tass10/tecracing_telemetry/Imagens/FFT_Pressao_da_Linha_de_Freio.png

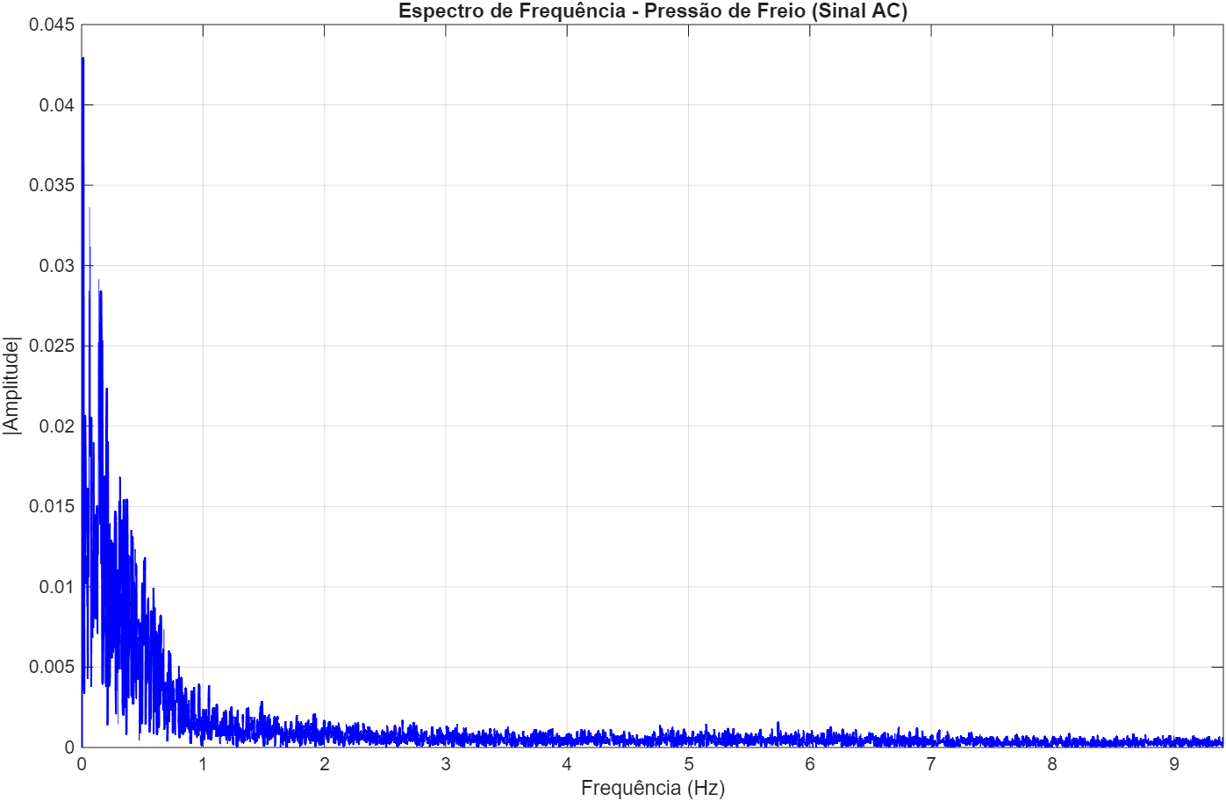
Imagens/FFT_Pressao_da_Linha_de_Freio.png
