tass10/tecracing_telemetry/Imagens/FFT_Temperatura_da_agua_do_motor.png

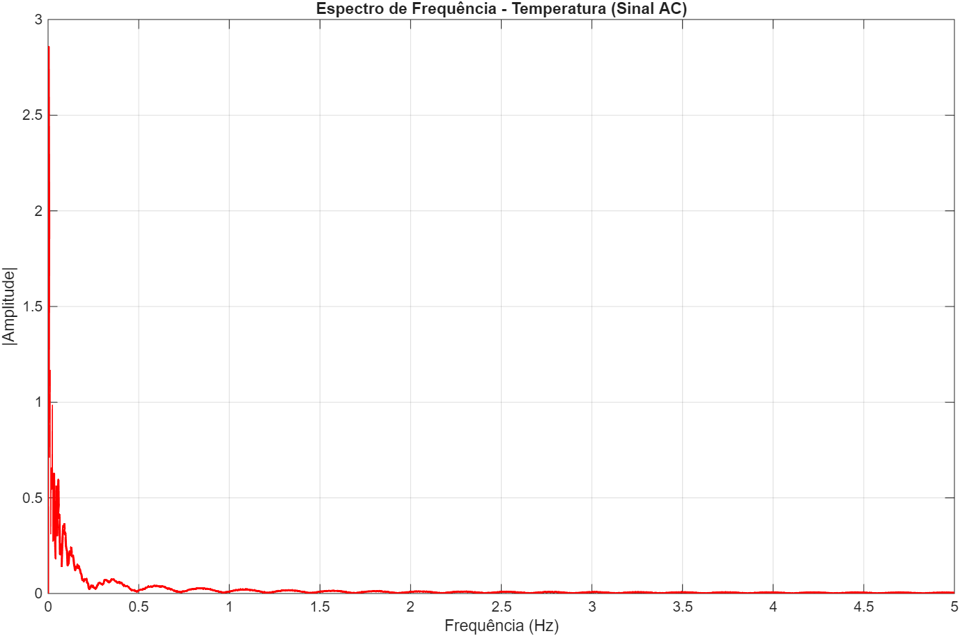
Imagens/FFT_Temperatura_da_agua_do_motor.png
