tass10/tecracing_telemetry/Imagens/Pressao_de_Freio_Comparação_de_Filtros_10_Hz.png

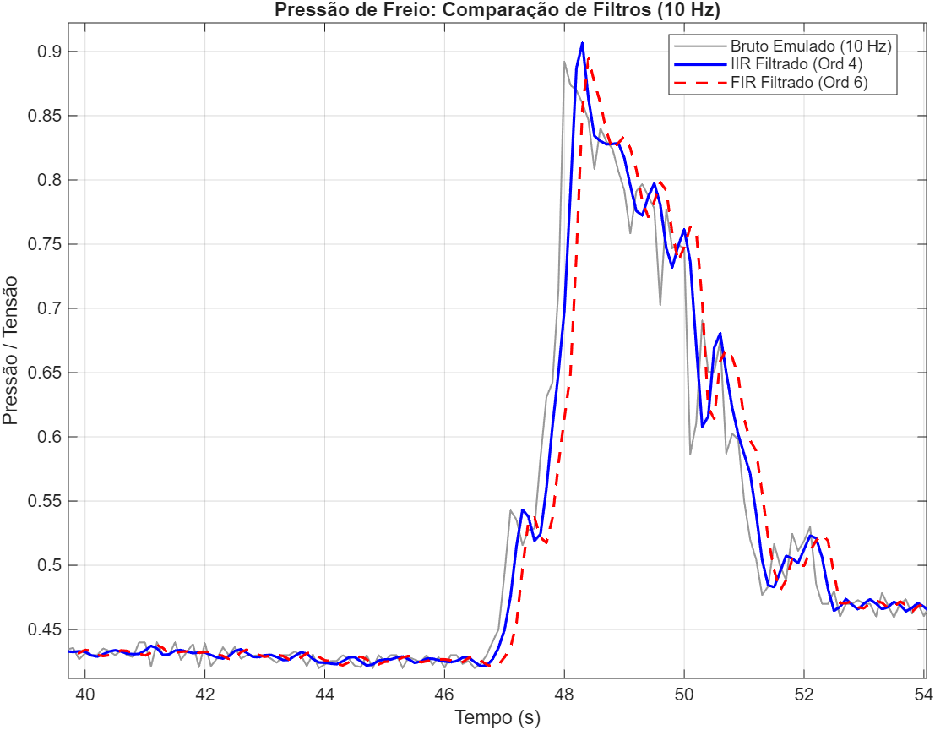
Imagens/Pressao_de_Freio_Comparação_de_Filtros_10_Hz.png
