tass10/tecracing_telemetry/Imagens/Temperatura_da_Agua_Comparação_de_Filtros_10_Hz.png

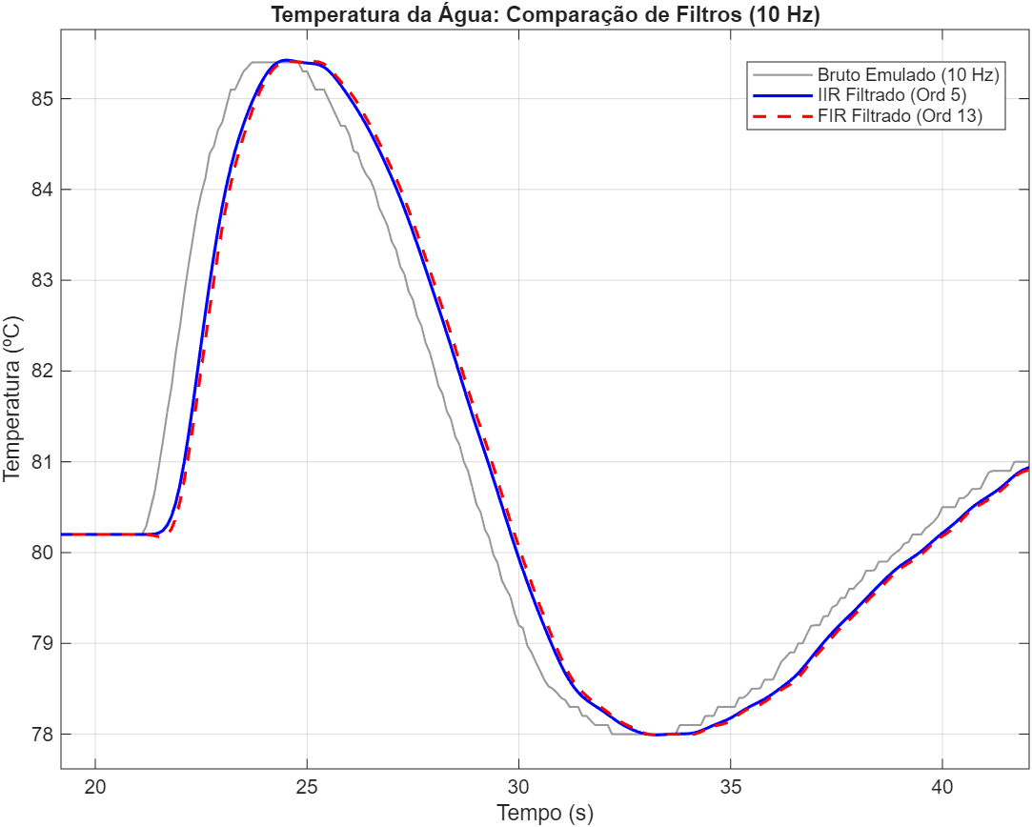
Imagens/Temperatura_da_Agua_Comparação_de_Filtros_10_Hz.png
