tass10/tecracing_telemetry/Imagens/Sistema_Transmissor_Teste.jpg

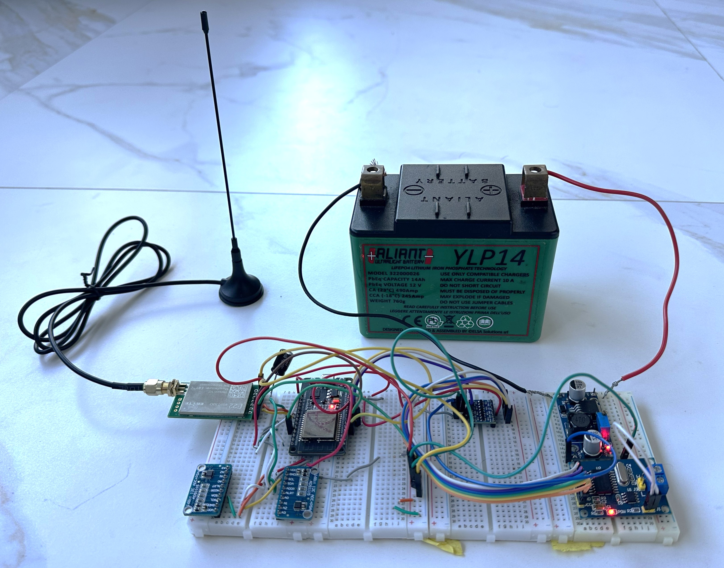
Imagens/Sistema_Transmissor_Teste.jpg
