tass10/tecracing_telemetry/Schematics/20260430_Telemetry_Schematic_Receiver_Tassio.PDF

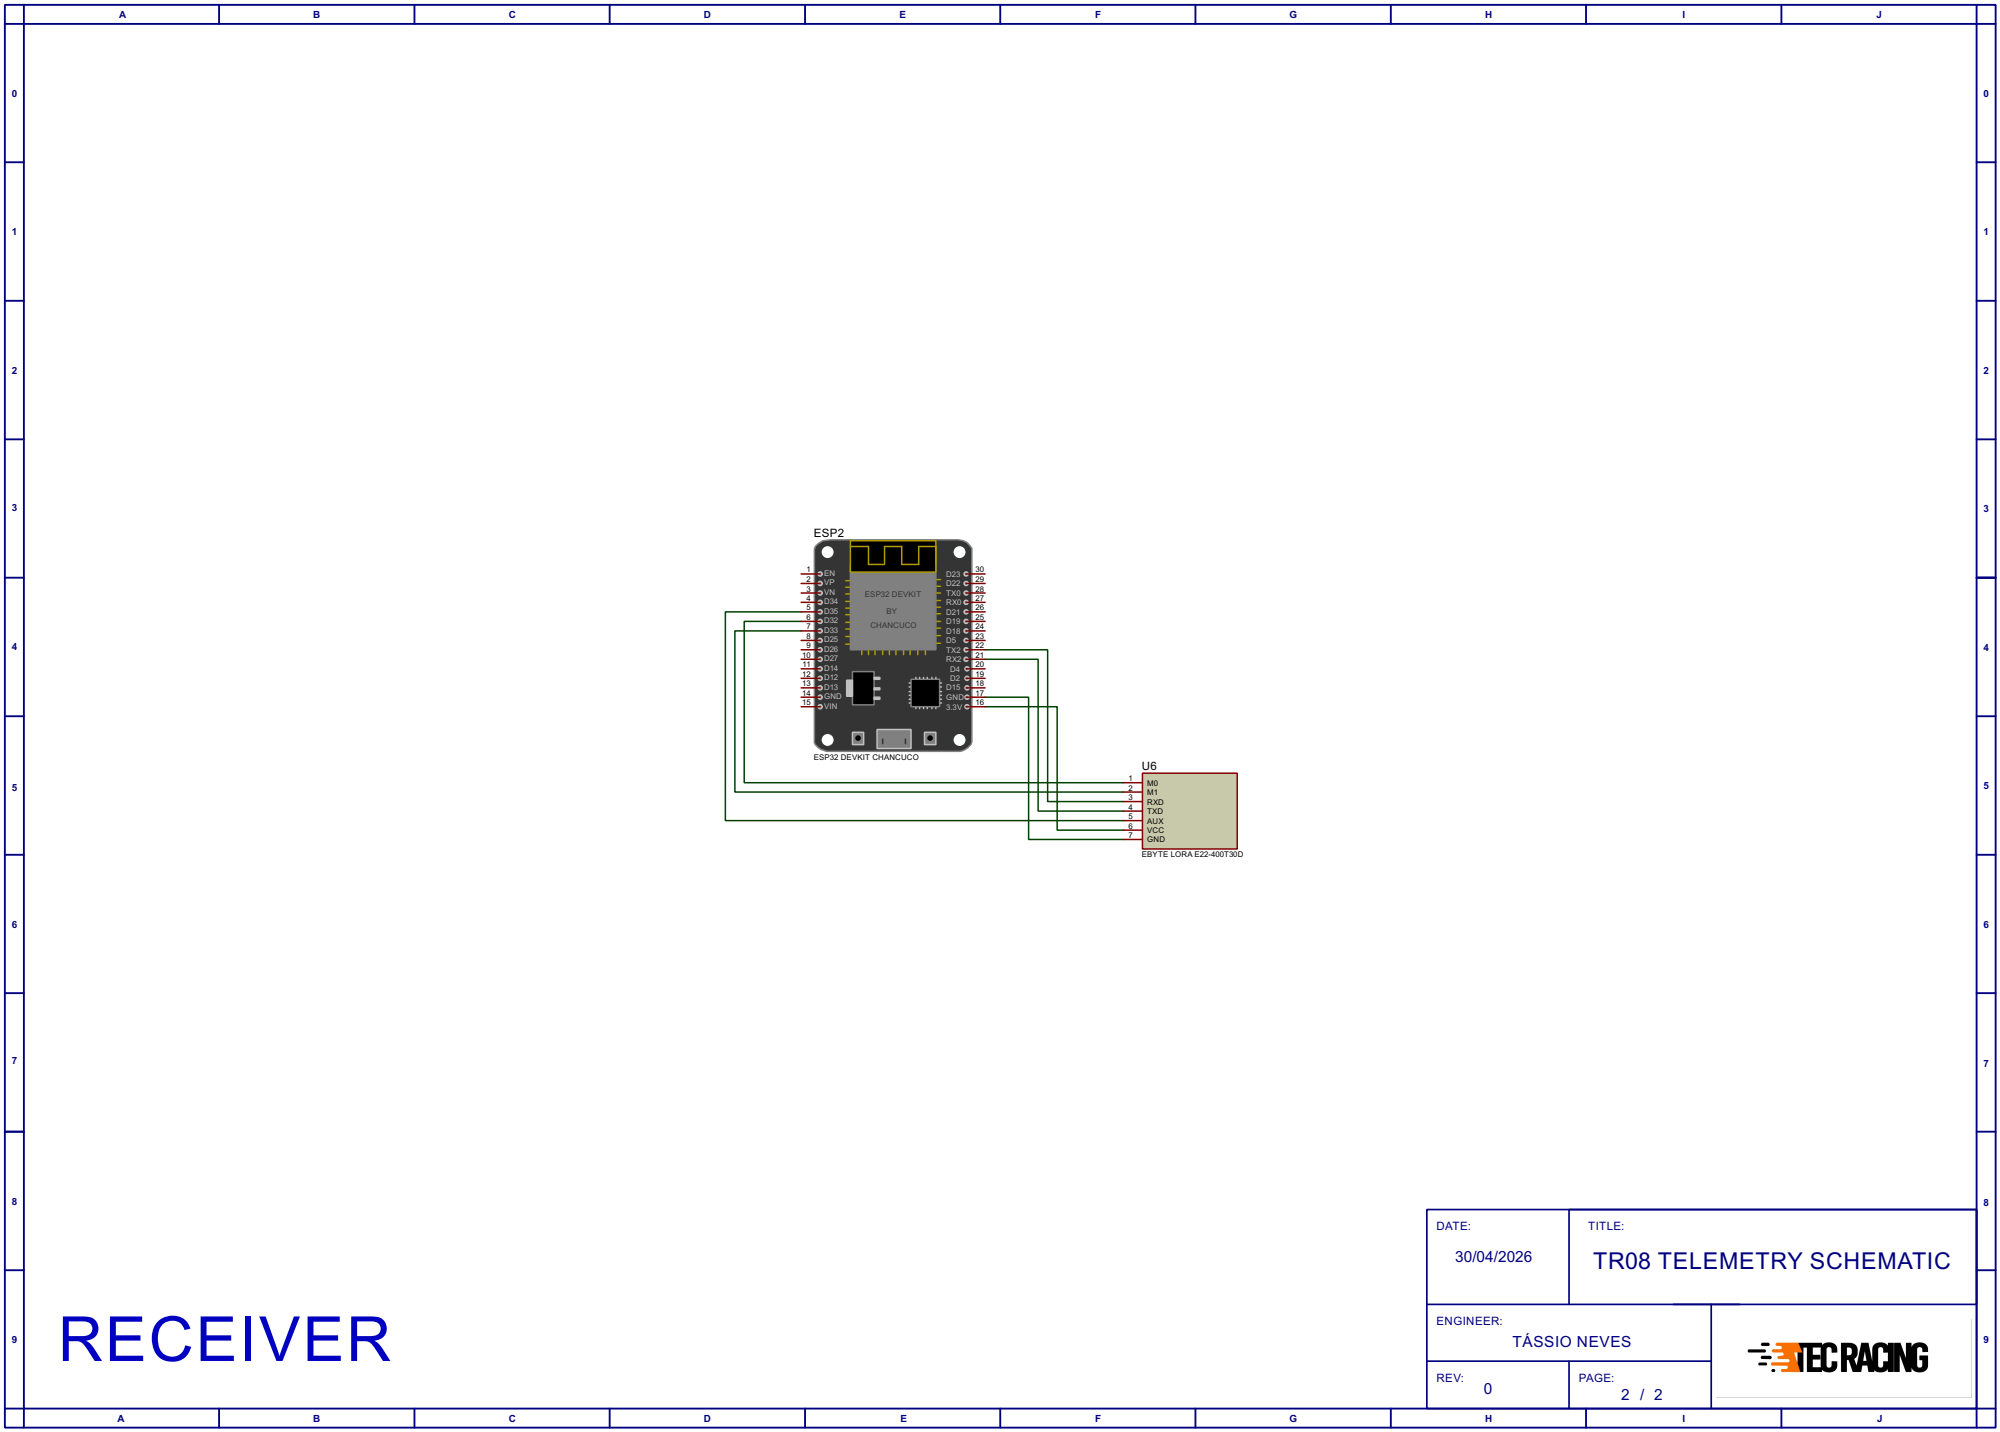
[picture p15: page 1]

6 | 25
7 | 24

DATE: 30/04/2026 | TITLE: TR08 TELEMETRY SCHEMATIC

ENGINEER: TÁSSIO NEVES
