tass10/tecracing_telemetry/Schematics/20260430_Telemetry_Schematic_Transmitter_Tassio.PDF

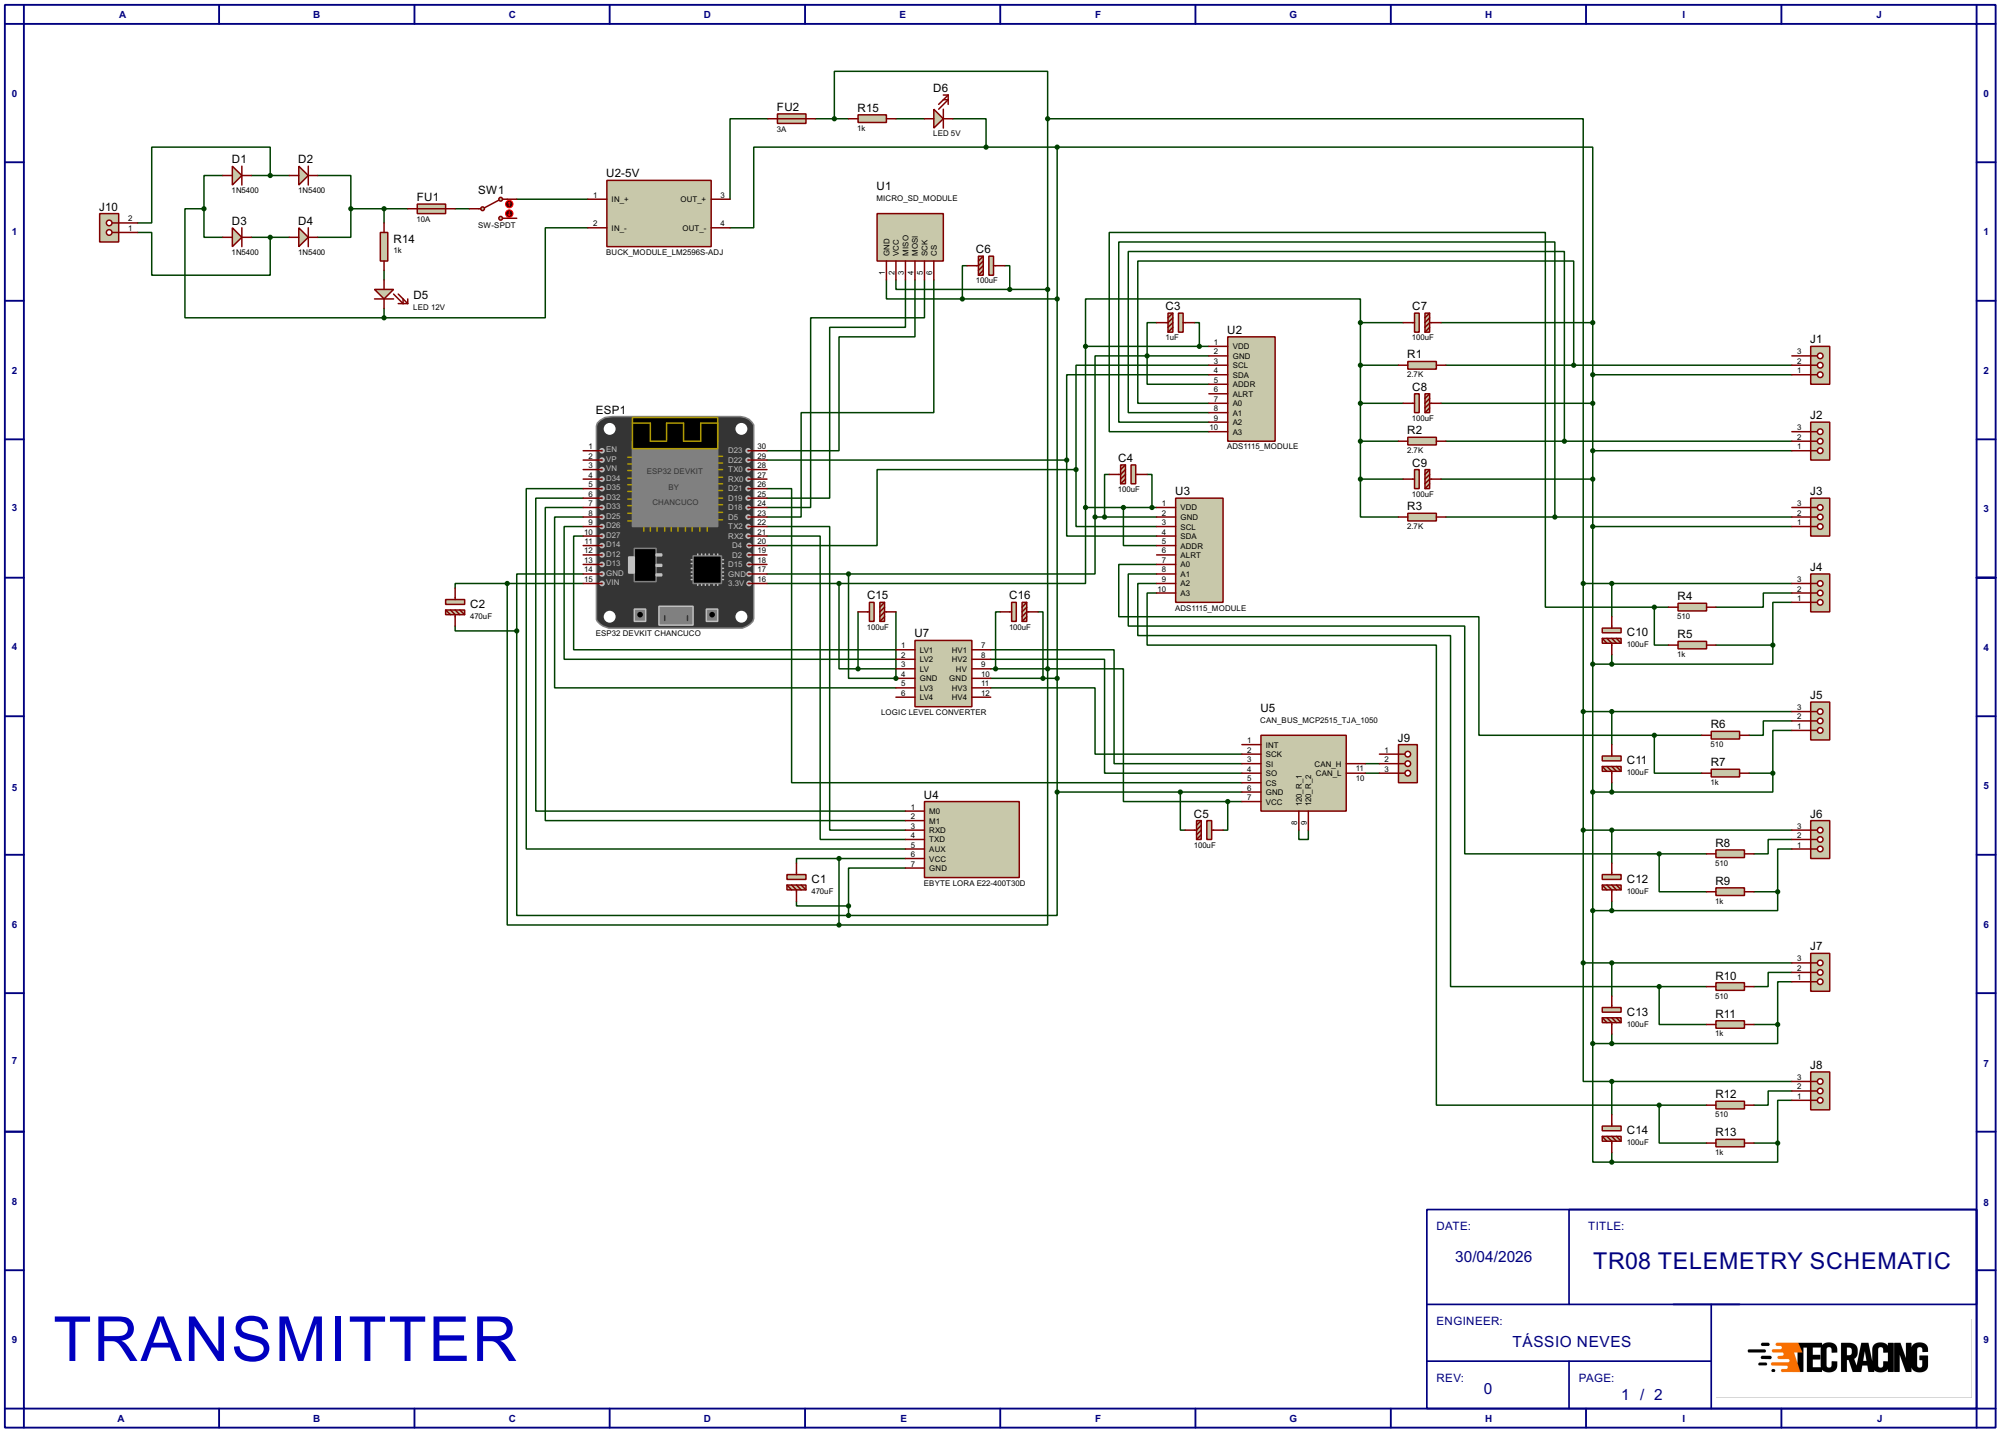
[picture p16: page 1]

SCL SDA ADDR ALRT A0
4 5

ESP32 DEVKIT CHANCUCO

4 | LV3 LV4 | 10 HV3
6 | | 11 HV4 12

U5 CAN_BUS_MCP2515_TJA_1050

DATE: 30/04/2026 | TITLE: TR08 TELEMETRY SCHEMATIC

ENGINEER: TÁSSIO NEVES
