tass10/tecracing_telemetry/Schematics/20260429_Telemetry_Simplified_Schematic_Transmitter_Leonardo.pdf

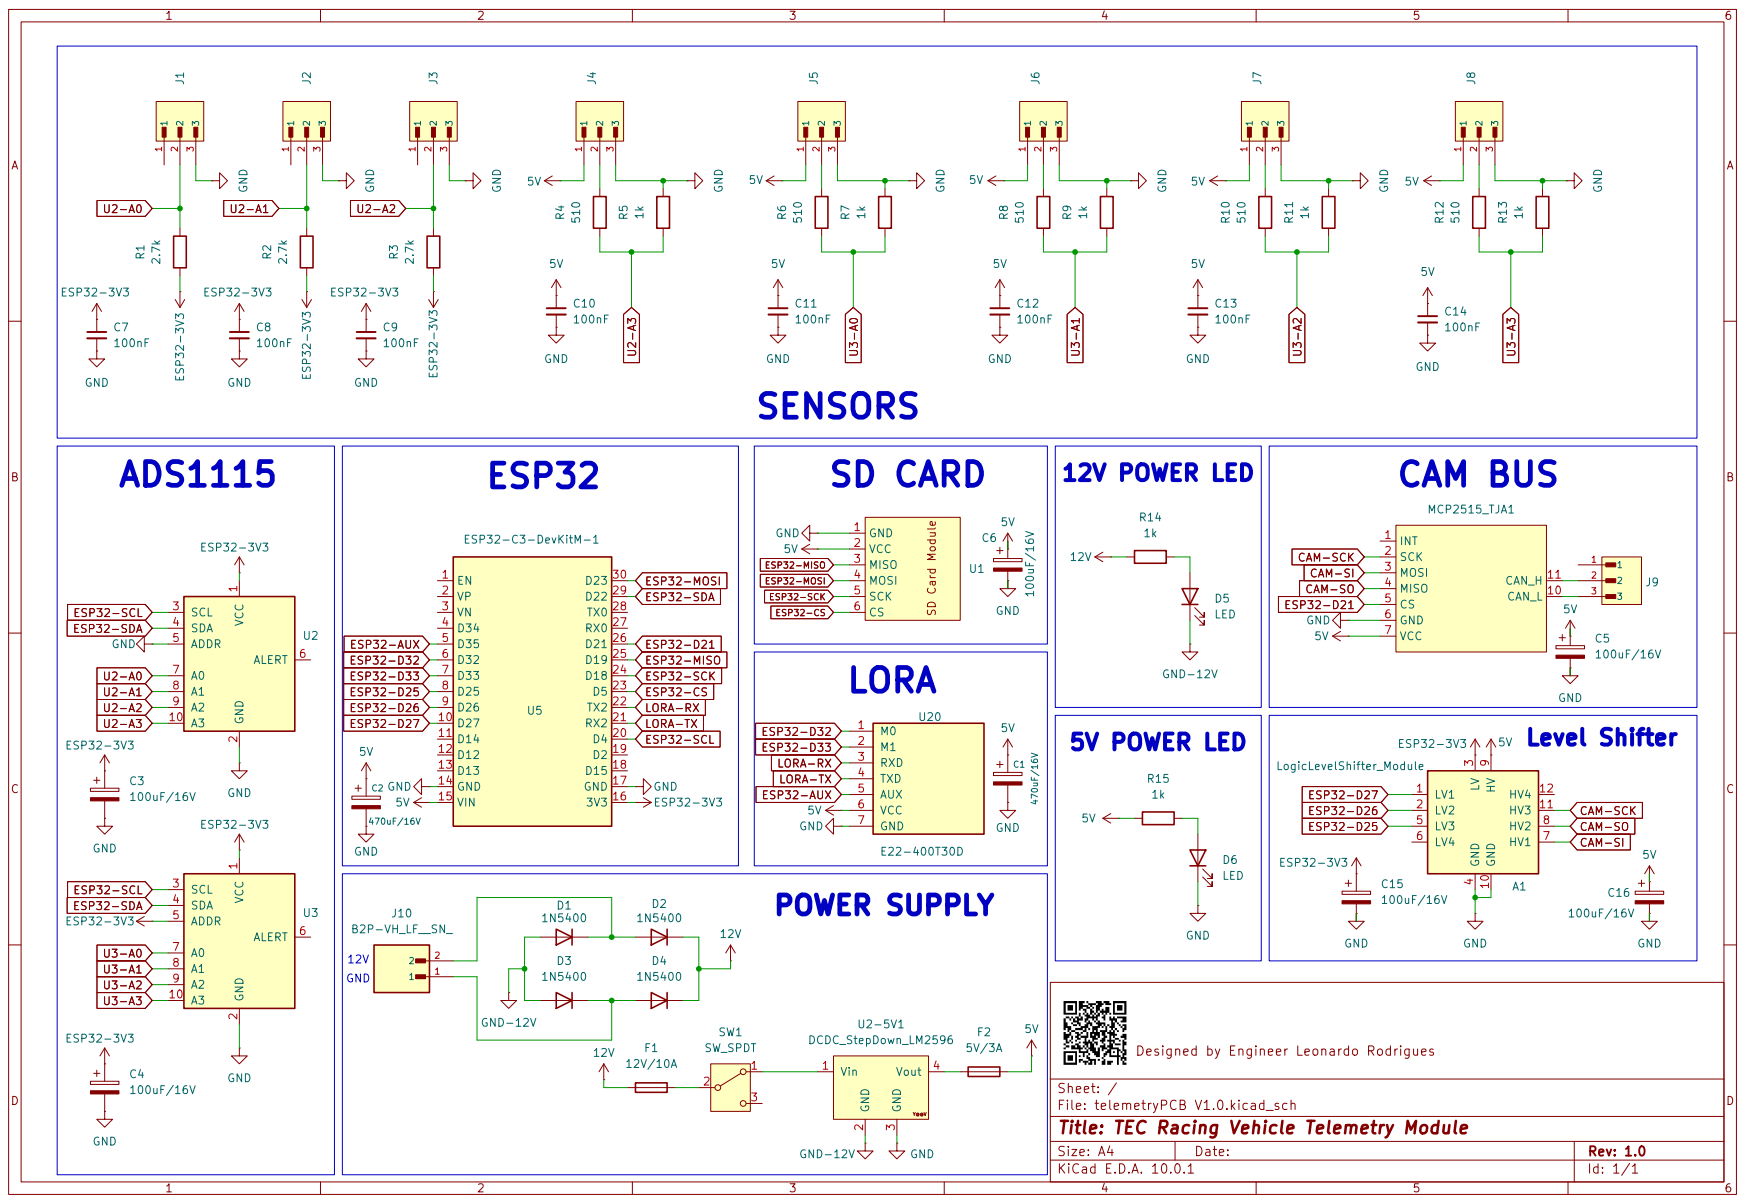
[picture p17: page 1]
