tass10/tecracing_telemetry/(commit log)

2026-05-01 added codes
    [telemetria_1775664765.csv, telemetria_1775664858.csv, telemetria_1775664879.csv, telemetria_1775664952.csv, telemetria_1775665259.csv, telemetria_1775665389.csv, telemetria_1775665505.csv, telemetria_1775665545.csv]
2026-05-07 added images
    [telemetria_1777995023.csv, telemetria_1777995343.csv]
2026-05-08 added demo.py and corrected file path
    [demo.py, main.py]
2026-05-11 folder organization
    [telemetria_1775664765.csv, telemetria_1775664858.csv, telemetria_1775664879.csv, telemetria_1775664952.csv, telemetria_1775665259.csv, telemetria_1775665389.csv, telemetria_1775665505.csv, telemetria_1775665545.csv]
2026-05-11 added filters in main.py
2026-05-11 updated w/ higher quality pcb image
2026-05-13 deleted gerbers
